jaromir-sukuba/retrobsd_sdram_brd/README

SDRAM board for RetroBSD
http://retrobsd.org/wiki/doku.php
http://retrobsd.org/viewtopic.php?f=3&t=5004
