jaromir-sukuba/retrobsd_sdram_brd/doc/schem.pdf

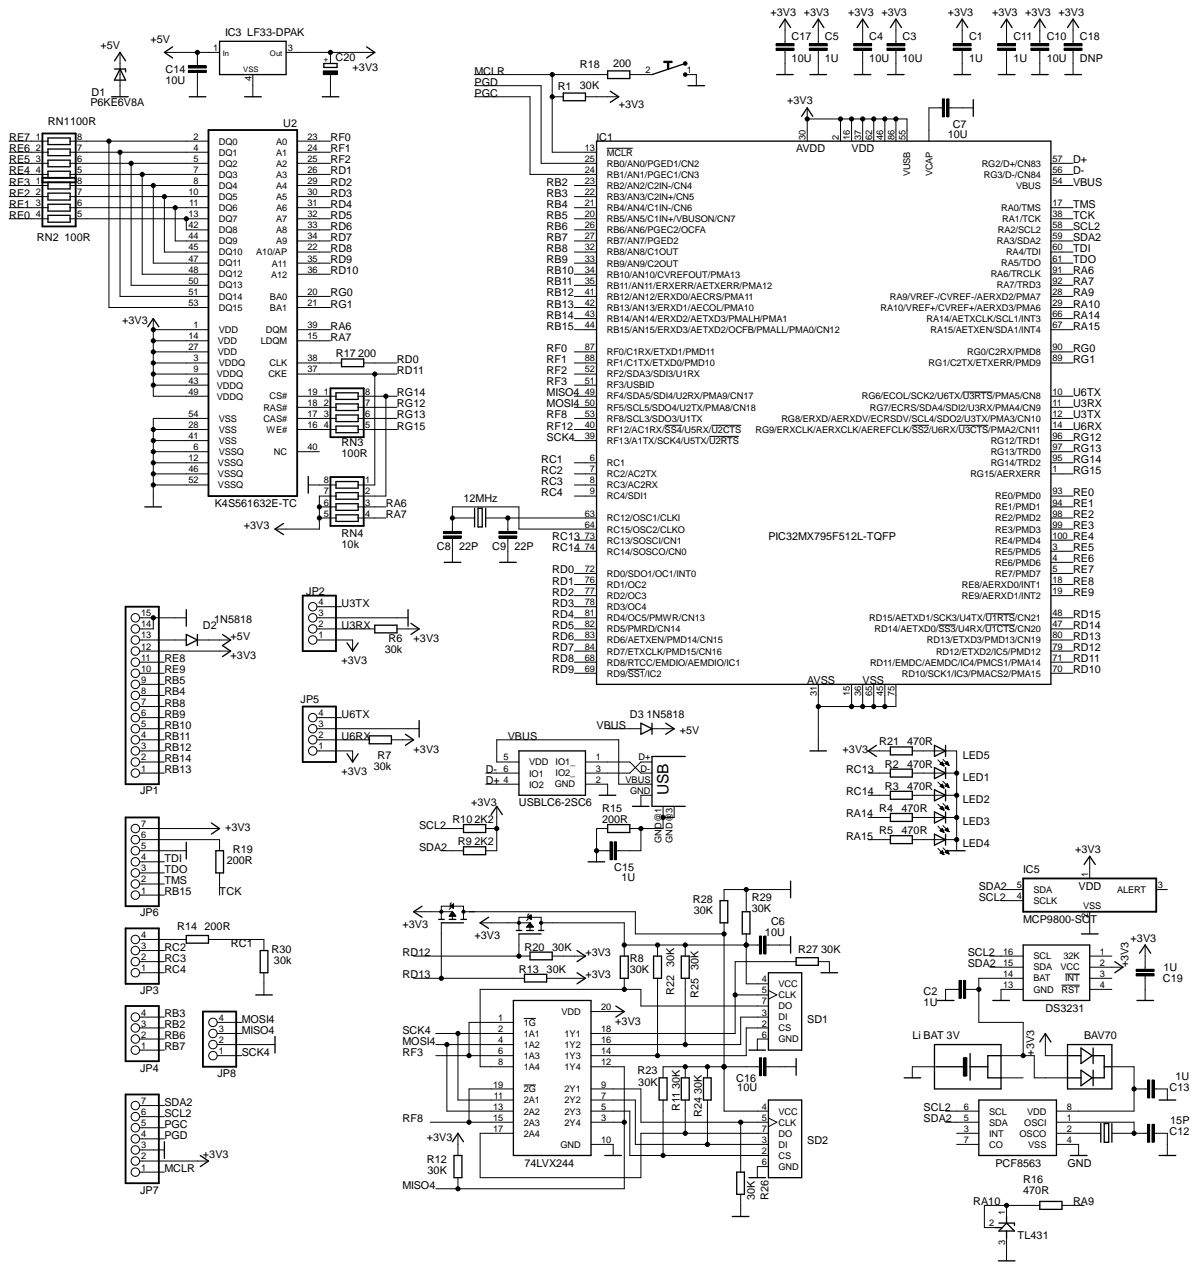
[picture p1: page 1]
